RakshithSuresh2001/argo-rv32-systolic-ihp130/docs/argo_layout.png

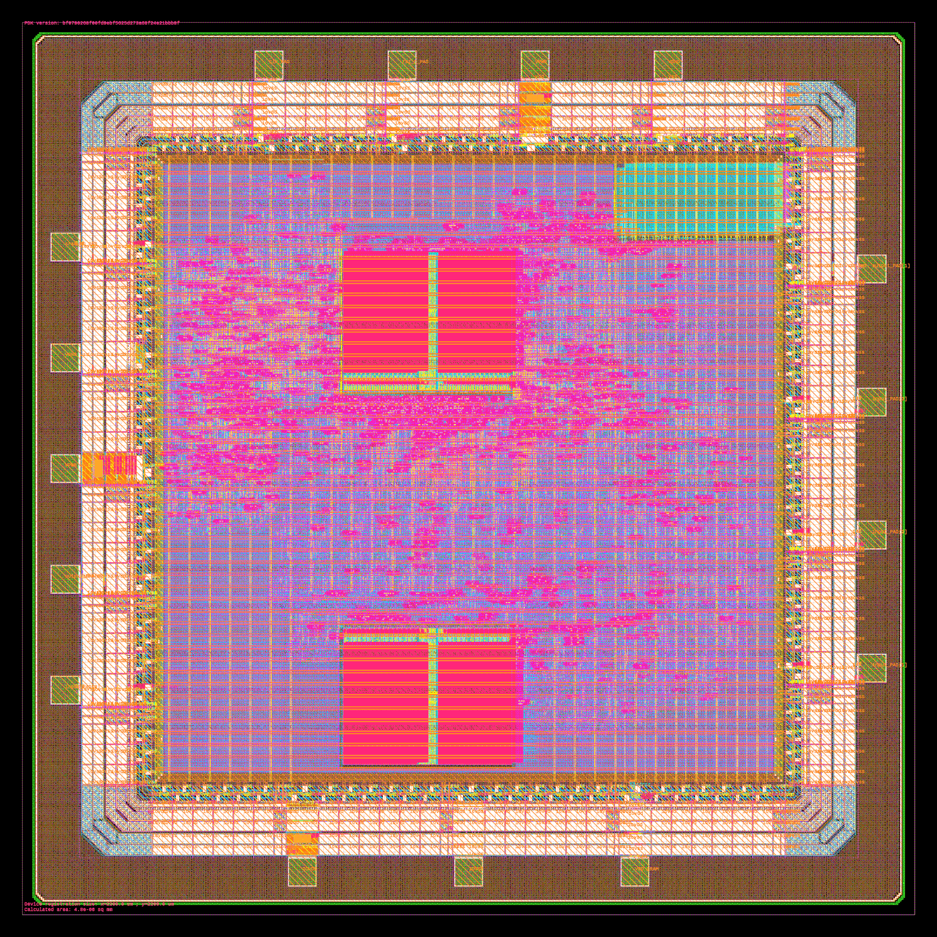
docs/argo_layout.png
