RakshithSuresh2001/argo-rv32-systolic-ihp130/docs/argo_sram_block.png

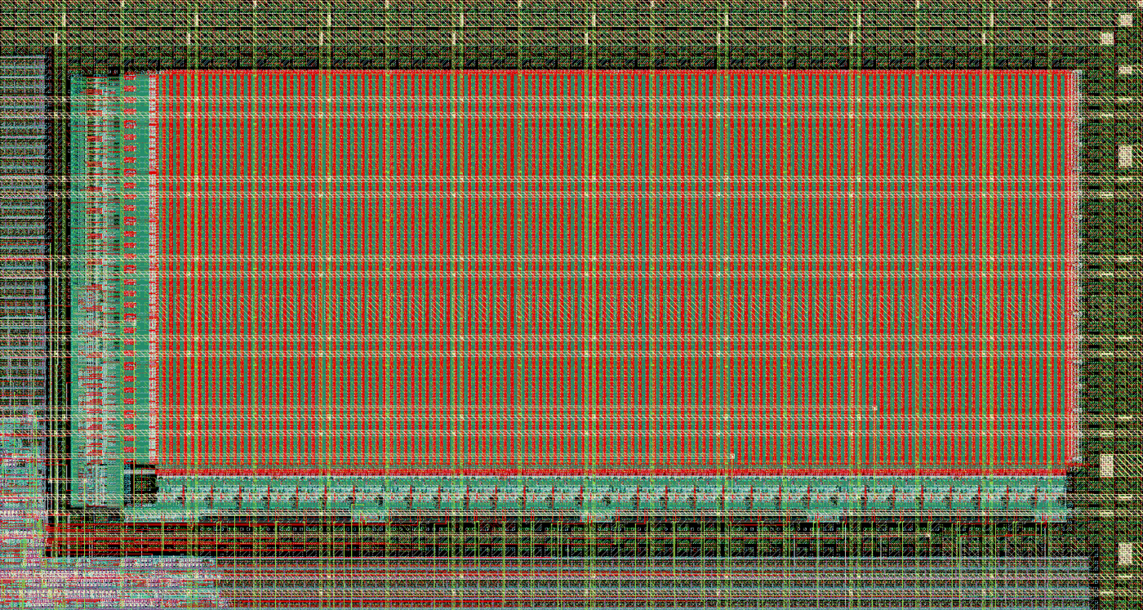
docs/argo_sram_block.png
