RakshithSuresh2001/argo-rv32-systolic-ihp130/(commit log)

2026-10-20 SRAM test block, 2.2 mm die, timing fix, CI regression script
2026-10-24 v2.2: 600 um repair wire cap (slow WNS -1.38 ns), signoff gate, GLS POST on routed netlist, waivers, v2.2 results
2026-10-24 GLS: POST passes with typical-corner SDF delays, both strap settings
2026-11-07 README: tape-out numbers and die image
2026-11-07 README: add KLayout-color die image
